miguelmanguerra/Gripper-Arm/Budget/Receipts and Photos/JLCPCB Invoice.pdf

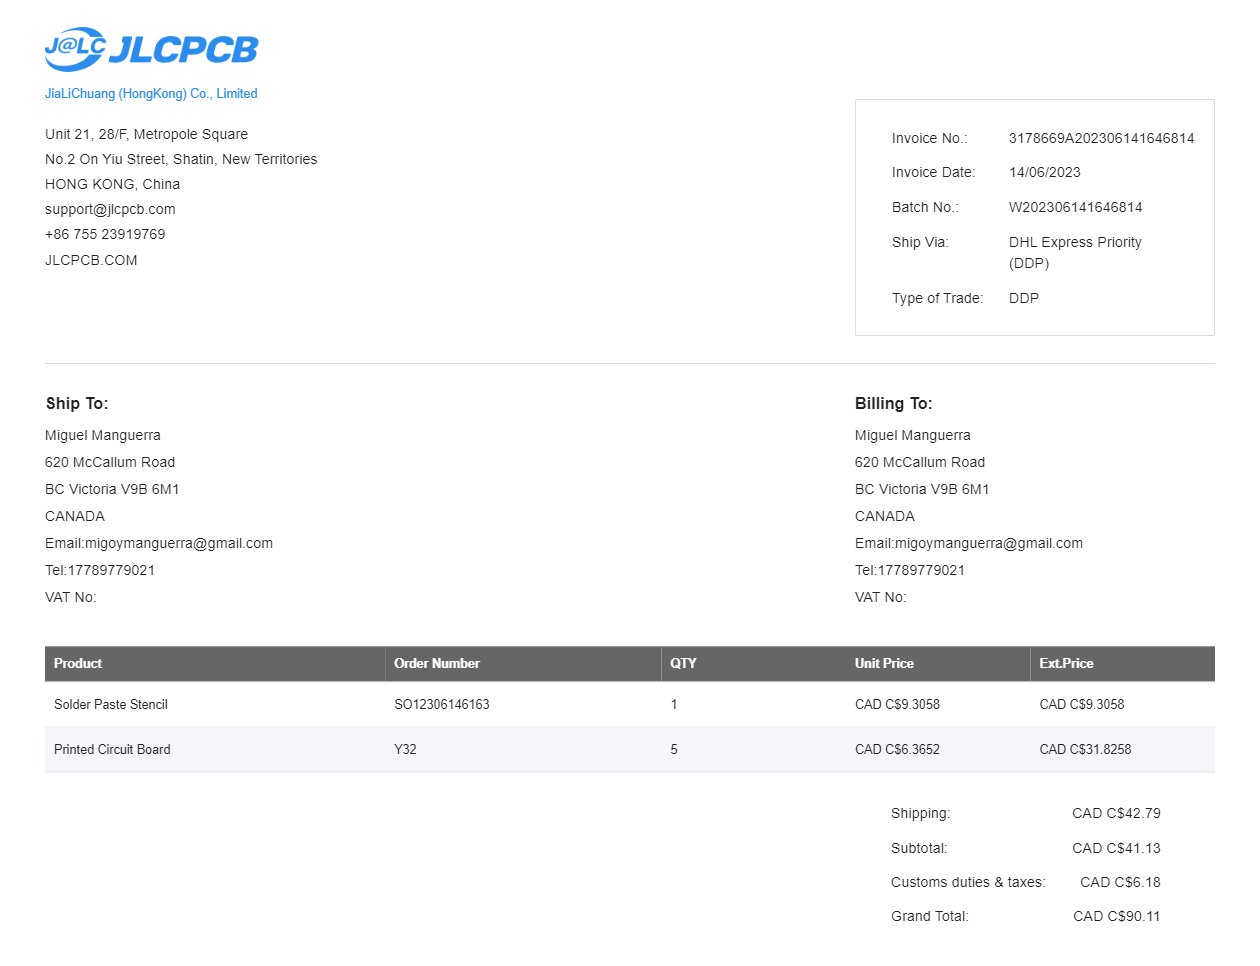
[picture p1: figure]
