miguelmanguerra/Gripper-Arm/Budget/Receipts and Photos/Force Sensors - DigiKey.png

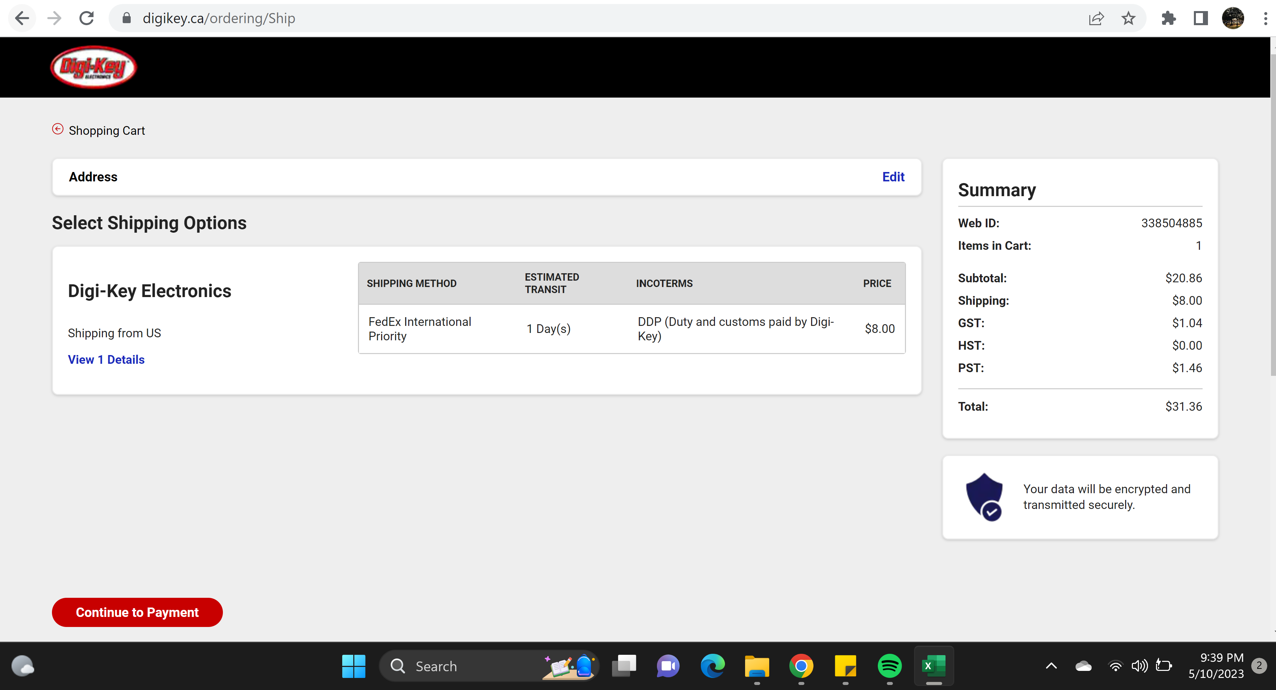
Budget/Receipts and Photos/Force Sensors - DigiKey.png
