miguelmanguerra/Gripper-Arm/Budget/Receipts and Photos/Force Sensors Reciept - DigiKey.png

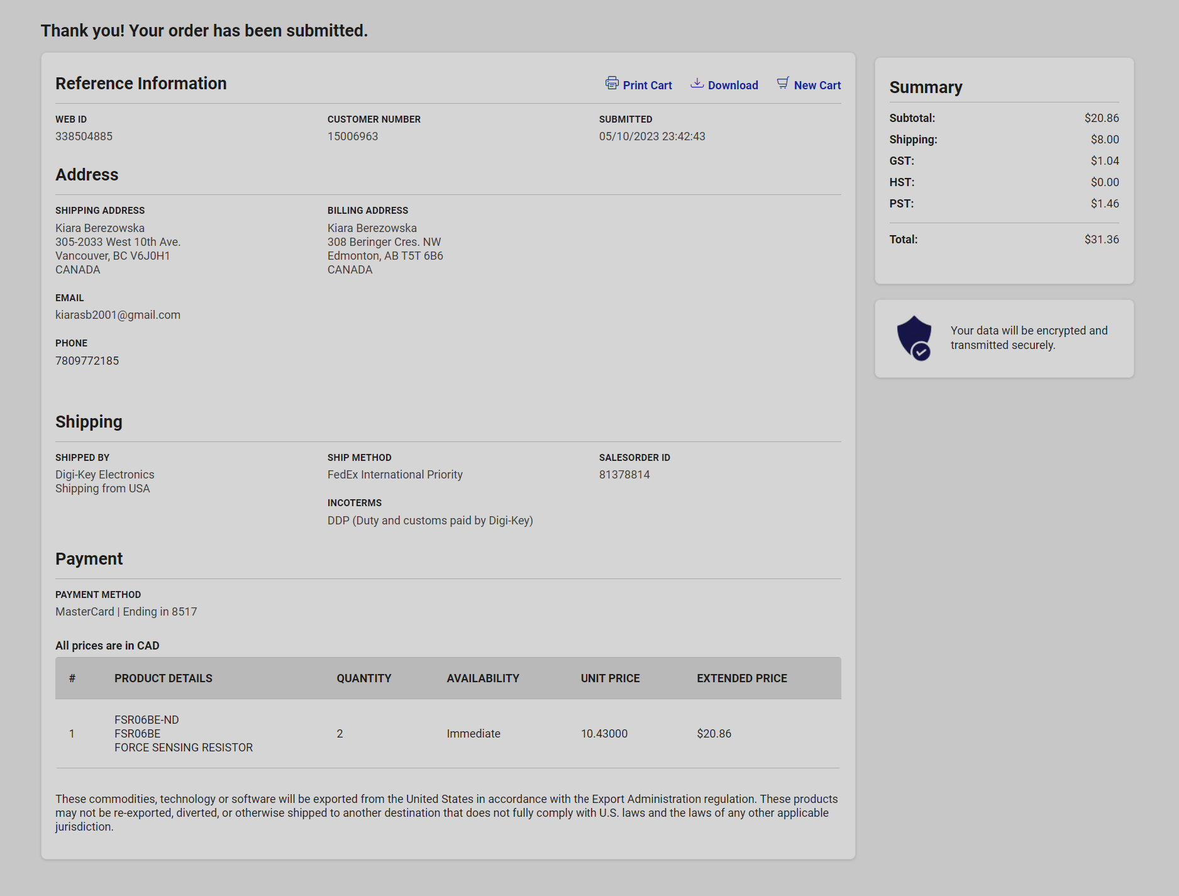
Budget/Receipts and Photos/Force Sensors Reciept - DigiKey.png
