miguelmanguerra/Gripper-Arm/Budget/Receipts and Photos/JLCPCB Credit Card Charge.png

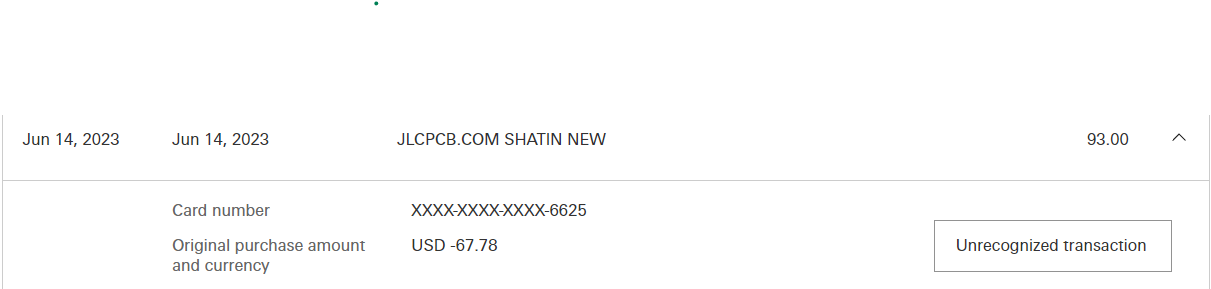
Budget/Receipts and Photos/JLCPCB Credit Card Charge.png
