miguelmanguerra/Gripper-Arm/Electrical/Gripper PCB/Manufacturing Files/BOM/BOM/Bill of Materials-Gripper PCB(X1).xlsx

Sheet: Manufacturing
 |  | Bill of Materials for |  | Gripper PCB.PrjPcb
 |  | Source Data From: | Gripper PCB.PrjPcb
 |  | Variant: | X1
 |  | Report Date: | 2023-06-14 1:41 AM
 |  |  |  | Primary |  |  |  |  | Secondary
Altium Vault P/N | Designator | Description | Qty | Supplier | Supplier Part Number | Manufacturer | Manufacturer Part Number | Supplier Unit Price | Supplier | Supplier Part Number | Manufacturer | Manufacturer Part Number | Supplier Unit Price
CM105X7R105K16ATH, GRT188C8YA105KE13D, CC0603KRX7R6BB105 | C1, C2, C9, C28, C29 | CAP CER 1UF 16V X7R 0603, CAP CER 1UF 35V X6S 0603, CAP CER 1UF 10V X7R 0603 | 5 | DigiKey | 478-CM105X7R105K16ATHCT-ND, 490-12297-1-ND, 311-1796-1-ND
C0603X104M3RAC7867, C0603C104K5RAC7411 | C3, C5, C6, C7, C10, C11, C12, C13, C16, C24, C30, C31, C32, C36, C37, C38 | CAP CER 0.1UF 25V X7R 0603, CAP CER 0.1UF 50V X7R 0603 | 16 | DigiKey | 399-13148-1-ND, 399-C0603C104K5RAC7411CT-ND
GRT188C81E475KE13D | C4 | CAP CER 4.7UF 25V X6S 0603 | 1 | DigiKey | 490-12295-1-ND
GRT188R61C106ME13D | C8 | CAP CER 10UF 16V X5R 0603 | 1 | DigiKey | 490-12318-1-ND
VJ0603A180JXACW1BC | C14, C15 | CAP CER 18PF 50V C0G/NP0 0603 | 2 | DigiKey | 720-1524-1-ND
CL32B106KBJNNNE | C17, C18, C19, C20, C25 | CAP CER 10UF 50V X7R 1210 | 5 | DigiKey | 1276-3387-1-ND
CL21A475KBQNNNE | C21, C22 | CAP CER 4.7UF 50V X5R 0805 | 2 | DigiKey | 1276-1248-1-ND
GRM1885C1H272JA01D | C23 | CAP CER 2700PF 50V C0G/NP0 0603 | 1 | DigiKey | 490-3283-1-ND
CL31A226KAHNNNE | C26, C27 | CAP CER 22UF 25V X5R 1206 | 2 | DigiKey | 1276-3047-1-ND
06035C332JAT2A | C33, C34, C35 | CAP CER 3300PF 50V X7R 0603 | 3 | DigiKey | 478-10808-1-ND
UWR1E220MCL1GB | C39, C40 | CAP ALUM 22UF 20% 25V SMD | 2 | DigiKey | 493-16362-1-ND
LTST-C193TBKT-5A | D1, D3 | LED BLUE CLEAR CHIP SMD | 2 | DigiKey | 160-1827-1-ND
XZVGT53W-6 | D2, D5, D8, D10, D14 | LED GREEN CLEAR 2SMD | 5 | DigiKey | 1497-1243-1-ND
LTST-C190KAKT | D4 | LED RED CLEAR CHIP SMD | 1 | DigiKey | 160-1433-1-ND
ESD3V3D5B-TP | D6 | TVS DIODE 3.3VWM 12VC SOD523 | 1 | DigiKey | ESD3V3D5B-TPMSCT-ND
V3FL45-M3/H | D7 | 3A,45V,SMF,TRENCH SKY RECT. | 1 | DigiKey | V3FL45-M3/HGICT-ND
BAT165E6327HTSA1 | D9 | DIODE SCHOTT 40V 750MA SOD323-2 | 1 | DigiKey | BAT165E6327HTSA1CT-ND
TPD1E10B06QDPYRQ1 | D11 | TVS DIODE 5.5VWM 14VC 2X1SON | 1 | DigiKey | 296-TPD1E10B06QDPYRQ1CT-ND
ESD321DPYR | D12, D13 | TVS DIODE 3.6VWM 6.8VC 2X1SON | 2 | DigiKey | 296-51108-1-ND
CMP-00073-2 | IC1 | Voltage Level Translator Bidirectional 2 Circuit 4 Channel 100Mbps 14-TSSOP | 1 | DigiKey | 1727-NXB0104PWJCT-ND
CMP-00068-2 | IC2 | Buck Switching Regulator IC Positive Adjustable 0.8V 1 Output 3A 8-SOIC (0.154, 3.90mm Width) Exposed Pad | 1 | DigiKey | 1028-1502-1-ND
CMP-00074-1 | IC3 | LDO Regulator Positive Adj 0.8V to 5V 600mA 5-Pin SOT-25 T/R | 1 | DigiKey | AP7366-W5-7DICT-ND
CMP-00069-1 | IC4 | IC BRUSHED DC MOTOR 8SOIC | 1 | DigiKey | 296-43024-1-ND
10118193-0001LF | J1 | CONN RCPT USB2.0 MICRO B SMD R/A | 1 | DigiKey | 609-4616-2-ND
CMP-00070-1 | J2, J4, J5 | Connector Header 2 Position 3 mm Solder Right Angle Thru-Hole 2 Terminal 1 Port Micro-Fit 3.0™ | 3 | DigiKey | WM1860-ND
CMP-00071-1 | J3 | Connector Wire to Board Header 4 Position 3mm Solder Right Angle Thru-Hole Tray | 1 | DigiKey | WM1862-ND
SLF7032T-100M1R4-2PF | L1 | FIXED IND 10UH 1.4A 63.6 MOHM | 1 | DigiKey | 445-1998-1-ND
SRN4018-4R7M | L2 | FIXED IND 4.7UH 1.9A 84 MOHM SMD | 1 | DigiKey | SRN4018-4R7MCT-ND
CMP-00028-00002-1 | MH1, MH2 | M3 Mounting Hole Exposed | 2
CMP-14406-000041-1 | Q1, Q2 | TRANS NPN 45V 500MA TO236AB | 2 | DigiKey | 1727-4844-1-ND
RT0603FRE0710KL, RC0603FR-7W10KL | R1, R4, R5, R6, R10, R15, R25, R31, R32 | RES SMD 10K OHM 1% 1/10W 0603, RES 10K OHM 1% 1/5W 0603 | 9 | DigiKey | YAG2321CT-ND, 13-RC0603FR-7W10KLCT-ND
CRCW06031K00FKEB, RT0603FRE071KL | R2, R3, R7, R8, R9 | RES SMD 1K OHM 1% 1/10W 0603 | 5 | DigiKey | 541-2985-1-ND, YAG2323CT-ND
TLRZ1JTTD | R13, R14, R20, R21, R23 | RES 0 OHM JUMPER 0603 | 5 | DigiKey | 2019-TLRZ1JTTDCT-ND
RT0603FRE0747KL | R16, R19 | RES SMD 47K OHM 1% 1/10W 0603 | 2 | DigiKey | YAG3355CT-ND
RMCF0603FT3K30, ERJ-3EKF3301V | R17, R22 | RES 3.3K OHM 1% 1/10W 0603, RES SMD 3.3K OHM 1% 1/10W 0603 | 2 | DigiKey | RMCF0603FT3K30CT-ND, P3.30KHCT-ND
CRCW060368K0FKEA | R18 | RES SMD 68K OHM 1% 1/10W 0603 | 1 | DigiKey | 541-68.0KHCT-ND
CR0603-FX-3832ELF | R24 | RES SMD 38.3K OHM 1% 1/10W 0603 | 1 | DigiKey | CR0603-FX-3832ELFCT-ND
RL73H2ER10FTDF | R26 | RES 0.1 OHM 1% 1/2W 1210 | 1 | DigiKey | A138544CT-ND
ERJ-3EKF4700V | R27, R29, R30 | RES SMD 470 OHM 1% 1/10W 0603 | 3 | DigiKey | P470HCT-ND
CRCW0603154KFKEA | R28 | RES SMD 154K OHM 1% 1/10W 0603 | 1 | DigiKey | 541-154KHCT-ND
CRCW060322K0FKEAC | R33 | RES 22K OHM 1% 1/10W 0603 | 1 | DigiKey | 541-4036-1-ND
RK73H1JTTD6342F | R34 | RES 63.4K OHM 1% 1/10W 0603 | 1 | DigiKey | 2019-RK73H1JTTD6342FCT-ND
EVP-AWBD4A | S1, S2 | 3.0MM X 2.0MM / 1.6N / 0.13MM ST | 2 | DigiKey | P123438CT-ND
CMP-002-00006-1 | TP5, TP6, TP7, TP8, TP9, TP10, TP11, TP12, TP13, TP14, TP15 | 1.5mm Test Point 0.75mm hole size | 11
CMP-0511-00012-1 | U1 | Single-Chip USB to UART Bridge, 1024 Bytes EEPROM, -40 to 85 degC, 28-pin QFN, Tube | 1 | DigiKey | 336-1160-5-ND
CMP-00072-2 | U2 | Rx Txrx Module Wifi U.fl SMD | 1 | DigiKey | 1965-ESP32-WROOM-32UE-N4CT-ND
CMP-0186-00139-2 | U3 | Stand-Alone CAN Controller With SPI Interface, 18-Pin SOIC, Industrial Temperature, Tape and Reel | 1 | DigiKey | MCP2515T-I/SOCT-ND
CMP-2000-04923-2 | U4 | IC TRANSCEIVER HALF 1/1 8SO | 1 | DigiKey | 296-19416-5-ND
CMP-12757-000001-1 | U5 | IC REG BUCK 5V 2A TSOT26 | 1 | DigiKey | AP63205WU-7DICT-ND
CMP-00020-1 | U6 | AEC-Q100, 2.7 to 60V, 800kHz Variable gain current sense amplifier 8-TSSOP -40 to 125 | 1 | DigiKey | 296-17201-1-ND
CMP-0272-00929-3 | U7 | Single-Supply, Rail-to-Rail Operational Amplifier MicroAmplifier(TM) Series, 2.7 to 5.5 V, -40 to 85 degC, 5-pin SOT23 (DBV5), Green (RoHS & no Sb/Br) | 1 | DigiKey | 296-26275-1-ND
CMP-0272-00789-3 | U8 | Single-Supply, Rail-to-Rail Operational Amplifier MicroAmplifier(TM) Series, 2.5 to 5.5 V, -40 to 85 degC, 8-pin SOIC (D8), Green (RoHS & no Sb/Br) | 1 | DigiKey | 296-26254-1-ND
NX5032GA-8MHZ-EXS00A-CG07039 | Y1 | CRYSTAL 8.0000MHZ 18PF SMD | 1 | DigiKey | 644-1318-1-ND

Sheet: Project Information
Project Full Path | C:\Gripper-Arm\Electrical\Gripper PCB\Gripper PCB.PrjPcb
Project Filename | Gripper PCB.PrjPcb
Variant Name | X1
Data-Source Filename | Gripper PCB.PrjPcb
Data-Source Full Path | C:\Gripper-Arm\Electrical\Gripper PCB\Gripper PCB.PrjPcb
Title | Bill of Materials for Variant [X1] of Project [Gripper PCB.PrjPcb] (No PCB Document Selected)
Total Quantity | 123
Report Time | 1:41 AM
Report Date | 2023-06-14
Report Date & Tine | 2023-06-14 1:41 AM
Output Name | Bill of Materials
Output Type | BomReport
Output Generator Name | BOM
Output Generator Description | Bill of Materials
