miguelmanguerra/Gripper-Arm/Budget/Receipts.xlsx

Person | Date | Description | Supplier | Cost Per Item | Quantity | Total Cost with Taxes and Shipping | Is Reciept Photo in Folder? | Which Credit Card?
Kiara | 2023-05-10 | Force sensors | DigiKey | $10.43 | 2 | $31.36 | Yes | Servus
Miguel | 2023-06-14 | PCB | JLCPCB | $41.13 | 1 | $90.73 | Yes | HSBC
Miguel | 2023-06-15 | PCB Components | Digikey | $225.99 | 1 | $253.11 | Yes | HSBC
