miguelmanguerra/Gripper-Arm/Mechanical/ASSY, GRIPPER, ROBOTIC ARM, 2023.SLDASM

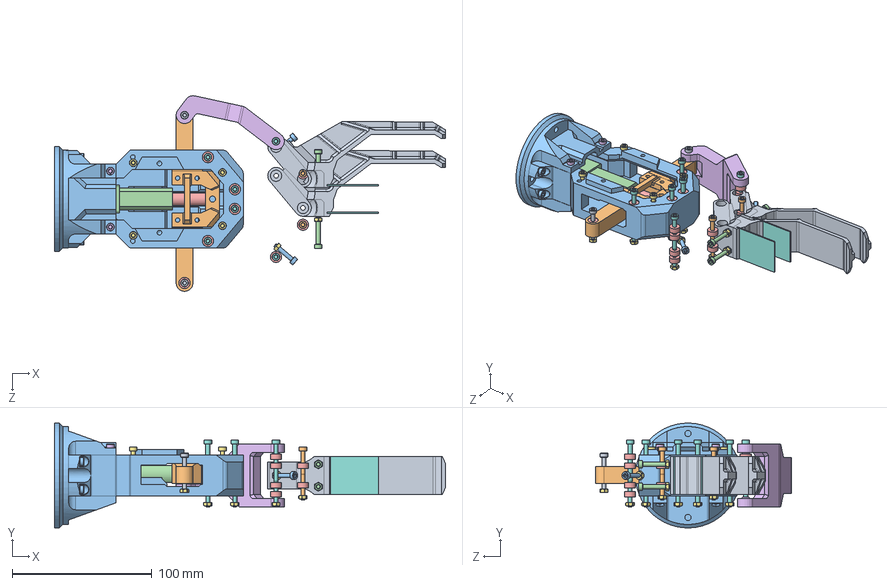
[picture p5: CAD file, 2023-05-04]
Mechanical/ASSY, GRIPPER, ROBOTIC ARM, 2023.SLDASM
279.6 x 75.0 x 139.9 mm
GRIPPER BODY,V2
LINEAR ACTUATOR, BODY,V2
LINEAR ACTUATOR, PISTON,V2
R1, GRIPPER,V2
90592A009_Steel Hex Nut x 20
91290A079_Alloy Steel Socket Head Screw x 6
91290A125_Black-Oxide Alloy Steel Socket Head Screw M3 x 25 x 2
91290A135_Alloy Steel Socket Head Screw x 2
91290A120_Alloy Steel Socket Head Screw x 6
91290A123_Alloy Steel Socket Head Screw x 4
693ZZ BEARING x 21
91290A136_Alloy Steel Socket Head Screw x 2
SLIDER V2, CFN, GRIPPER
FINGER, GRIPPER V2 x 2
91290A111_Alloy Steel Socket Head Screw (1) x 4
RUBBER PAD, GRIPPER, 2023 x 2
