miguelmanguerra/Gripper-Arm/Mechanical/GRIPPER BODY,V2.SLDPRT

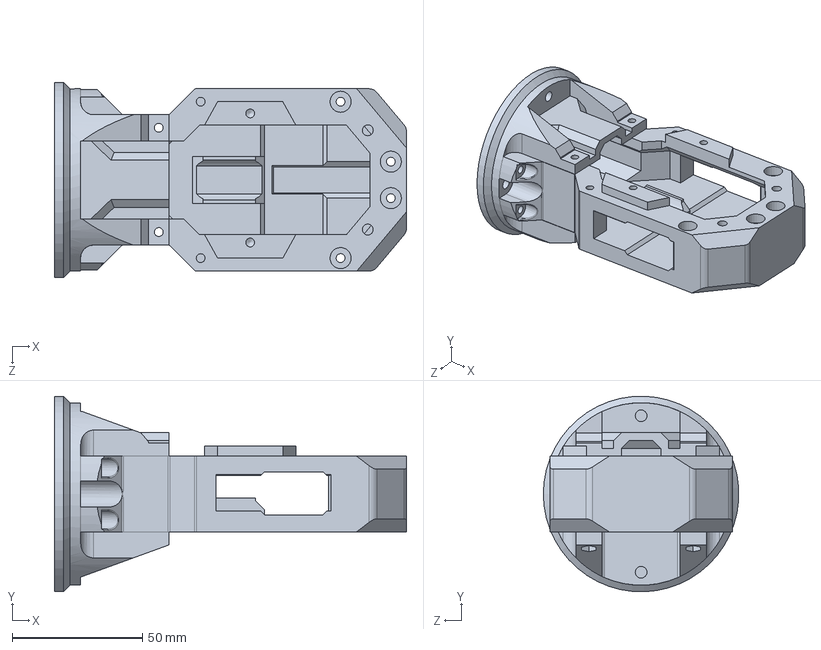
[picture p6: CAD file, 2023-06-16]
Mechanical/GRIPPER BODY,V2.SLDPRT
135.0 x 75.0 x 74.9 mm
