miguelmanguerra/Gripper-Arm/Mechanical/FINGER, GRIPPER V2.SLDPRT

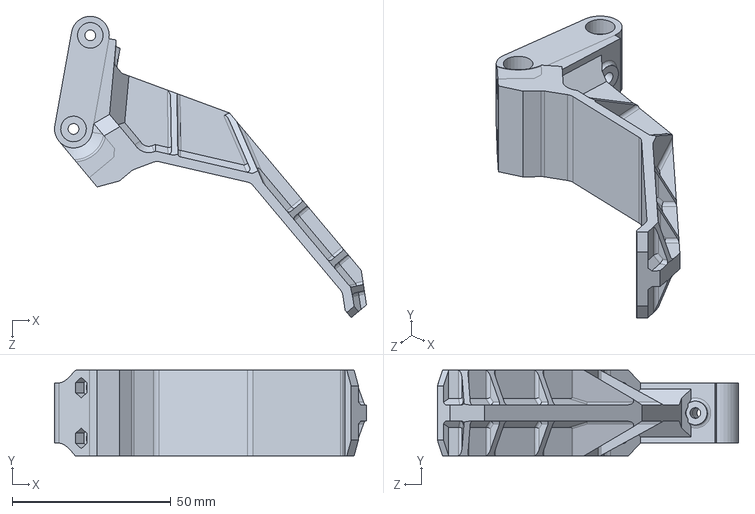
[picture p7: CAD file, 2023-05-04]
Mechanical/FINGER, GRIPPER V2.SLDPRT
98.4 x 27.0 x 95.1 mm
