miguelmanguerra/Gripper-Arm/Mechanical/FINGER, GRIPPER.SLDPRT

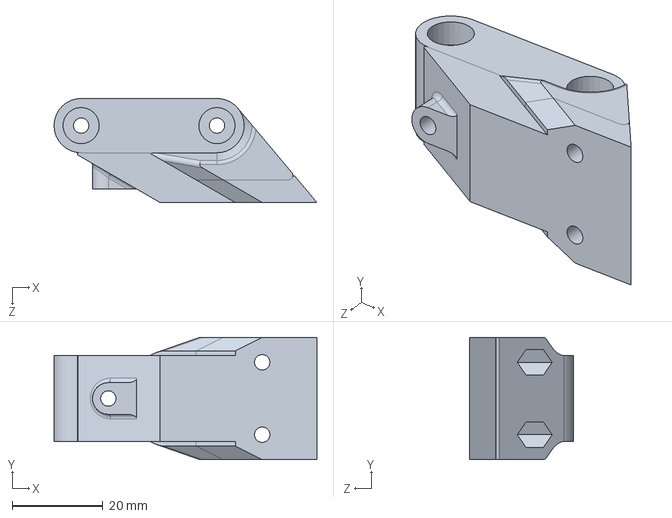
[picture p8: CAD file, 2023-05-04]
Mechanical/FINGER, GRIPPER.SLDPRT
58.1 x 27.0 x 23.0 mm
