miguelmanguerra/Gripper-Arm/Mechanical/SLIDER V2, CFN, GRIPPER.SLDPRT

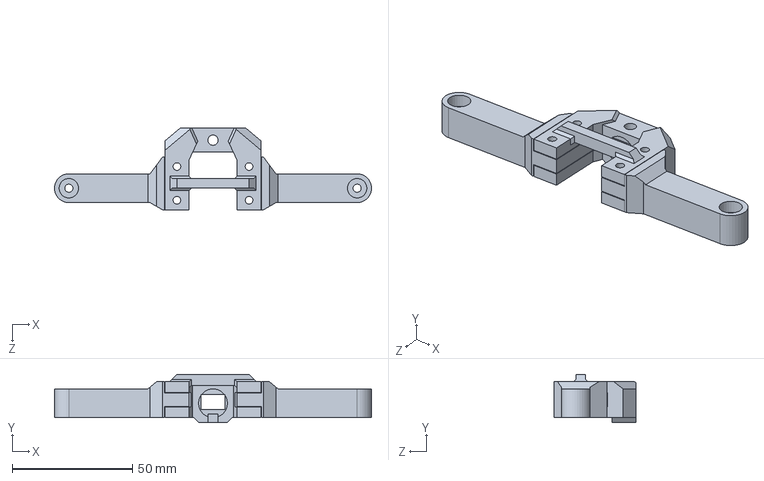
[picture p9: CAD file, 2023-05-04]
Mechanical/SLIDER V2, CFN, GRIPPER.SLDPRT
131.9 x 20.0 x 34.0 mm
