miguelmanguerra/Gripper-Arm/(list of files, cad)

Other CAD files:
Mechanical/3D Printed Solder Holder.STL
Mechanical/90592A009_Steel Hex Nut.SLDPRT
Mechanical/91290A079_Alloy Steel Socket Head Screw.SLDPRT
Mechanical/91290A111_Alloy Steel Socket Head Screw (1).SLDPRT
Mechanical/91290A120_Alloy Steel Socket Head Screw.SLDPRT
Mechanical/91290A123_Alloy Steel Socket Head Screw.SLDPRT
Mechanical/91290A125_Black-Oxide Alloy Steel Socket Head Screw M3 x 25.SLDPRT
Mechanical/91290A135_Alloy Steel Socket Head Screw.SLDPRT
Mechanical/91290A136_Alloy Steel Socket Head Screw.SLDPRT
Mechanical/ASSY, GRIPPER, ROBOTIC ARM, 2023.DXF
