miguelmanguerra/Gripper-Arm/Software/Force Sensor Testing.xlsx

Sheet: Sheet1
FSR_2 Input test
Load (kg) | Voltage tst 1 (V)
0 | 3.46
0.1 | 1.7
0.2 | 0.56
0.3 | 0.46
0.4 | 0.35
0.5 | 0.29
0.6 | 0.28
0.7 | 0.247
0.8 | 0.21
0.9 | 0.2
1 | 0.195
1.5 | 0.14
2 | 0.11
2.5 | 0.103
3 | 0.101
3.5 | 0.099
4 | 0.079
4.5 | 0.076

Sheet: Sheet2
Current Sensor Testing
Current (A) | ADC Reading
0.095 | 51.8
0.111 | 82.5
0.127 | 123
0.133 | 149.2
0.142 | 179.7
0.158 | 242.7
0.165 | 280.2
0.17 | 303.6
0.181 | 343.7
0.19 | 387.3
0.198 | 463.1
0.204 | 512.9
0.211 | 561.5
0.22 | 614.7

Sheet: FSR_2 Input Test + Sensor 2
FSR_2 Input Test + Sensor 2
Load (kg) | Voltage_test 1 (V) | ADC_test 1 | Voltage_test 2 (V) | ADC_test 2 | Voltage_test 3 (V) | ADC_test 3 | Voltage_test 4 (V) | ADC_test 4
0.1 | 0.14 | 48 | 0.12 | 45 | 0.13 | 30 | 0.129 | 25
0.2 | 0.19 | 80 | 0.15 | 46 | 0.19 | 109 | 0.145 | 45
0.3 | 0.27 | 175 | 0.24 | 145 | 0.19 | 100 | 0.21 | 140
0.4 | 0.33 | 260 | 0.28 | 210 | 0.21 | 120 | 0.23 | 150
0.5 | 0.39 | 330 | 0.26 | 290 | 0.25 | 150 | 0.26 | 190
1 | 0.58 | 560 | 0.5 | 450 | 0.32 | 320 | 0.4 | 360
1.5 | 0.56 | 549 | 0.55 | 540 | 0.55 | 530 | 0.5 | 460
2 | 0.6 | 590 | 0.64 | 650 | 0.61 | 590 | 0.56 | 560
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
