miguelmanguerra/Gripper-Arm/Electrical/Force Sensor Validation.xlsx

Equipment Used | Sensor 1 |  | Sensor 2 |  | Voltage Divider Calculations |  | Input Voltage | 3.3
Force Sensor - SHIMPO 30kg | Applied Force [kg] | Resistance [Ohms] | Applied Force [kg] | Resistance [Ohms] | Resistance (Force Sensor) | R2 Resistance | Output | Resolution
Multimeter - FLUKE 117 | 0.2 | 150000 | 0.2 | N/A | 150000 | 10000 | 0.20625
 | 0.4 | 30000 | 0.4 | 24000 | 145000 | 10000 | 0.2129032258 | 0.006653225806
 | 0.6 | 8000 | 0.6 | 10000 | 140000 | 10000 | 0.22 | 0.007096774194
 | 0.8 | 7900 | 0.8 | 6000 | 135000 | 10000 | 0.2275862069 | 0.007586206897
 | 1 | 6000 | 1 | 5900 | 130000 | 10000 | 0.2357142857 | 0.008128078818
 | 2 | 2000 | 2 | 1500 | 125000 | 10000 | 0.2444444444 | 0.00873015873
 | 3 | 500 | 3 | 1000 | 120000 | 10000 | 0.2538461538 | 0.009401709402
 | 4 | 450 | 4 | 600 | 115000 | 10000 | 0.264 | 0.01015384615
 | 5 | 230 | 5 | N/A | 110000 | 10000 | 0.275 | 0.011
 |  |  |  |  | 105000 | 10000 | 0.2869565217 | 0.01195652174
 |  |  |  |  | 100000 | 10000 | 0.3 | 0.01304347826
 |  |  |  |  | 95000 | 10000 | 0.3142857143 | 0.01428571429
 |  |  |  |  | 90000 | 10000 | 0.33 | 0.01571428571
 |  |  |  |  | 85000 | 10000 | 0.3473684211 | 0.01736842105
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
