miguelmanguerra/Gripper-Arm/Electrical/Gripper PCB/Manufacturing Files/Gripper PCB.pdf

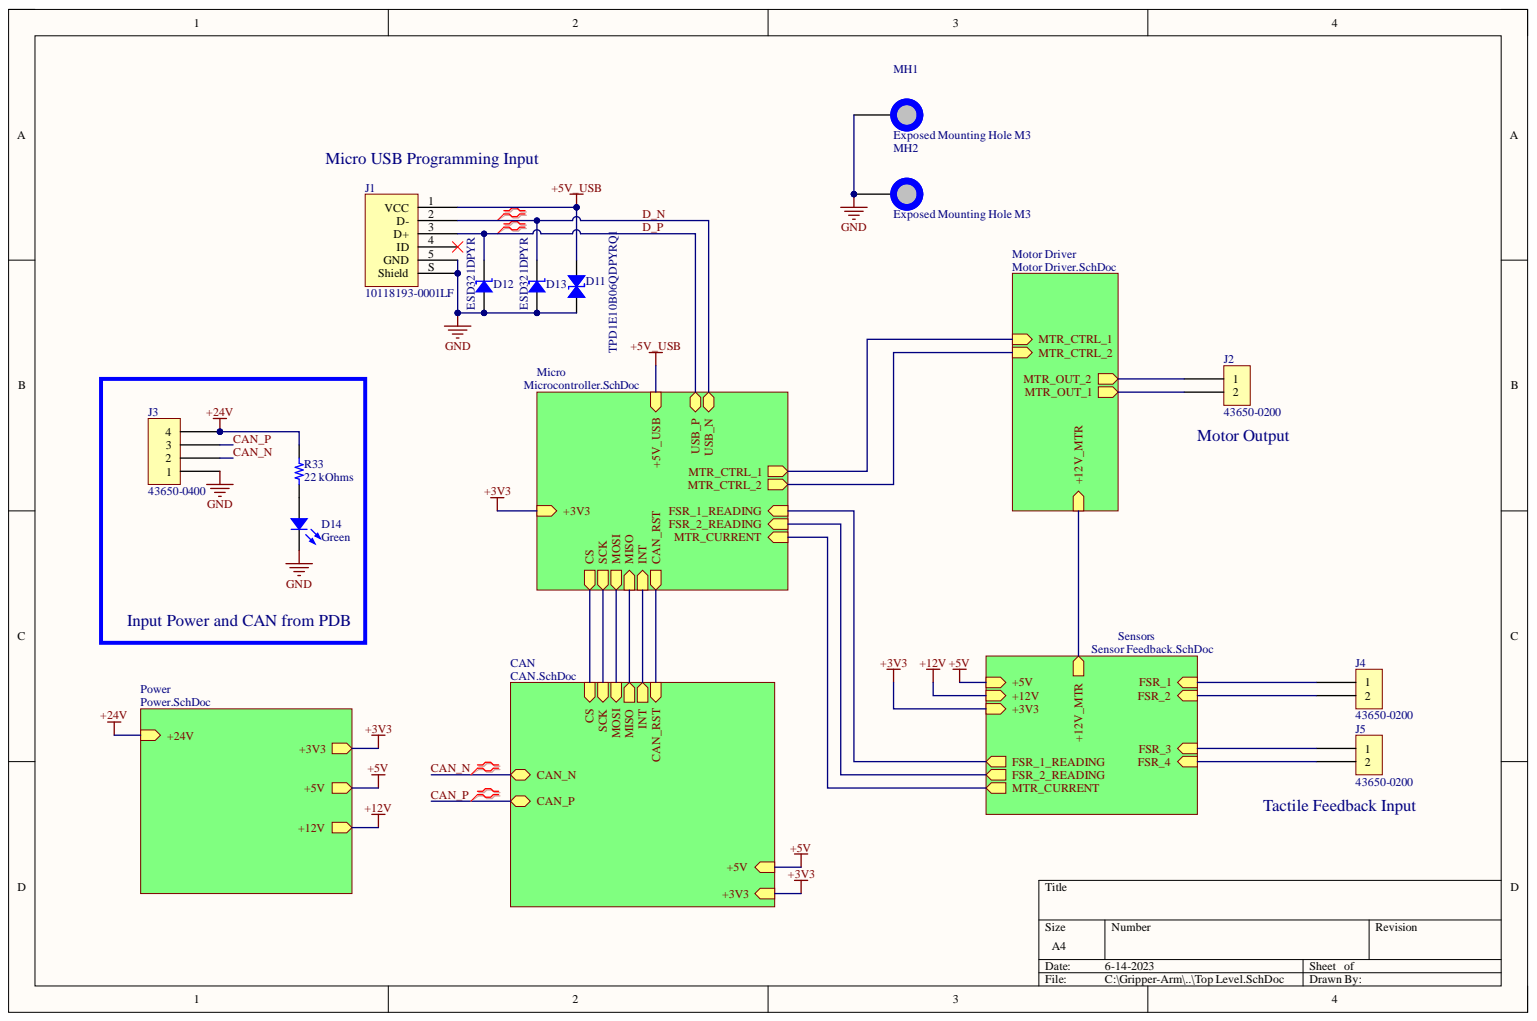
[picture p10: page 1]

Micro USB Programming Input

Input Power and CAN from PDB

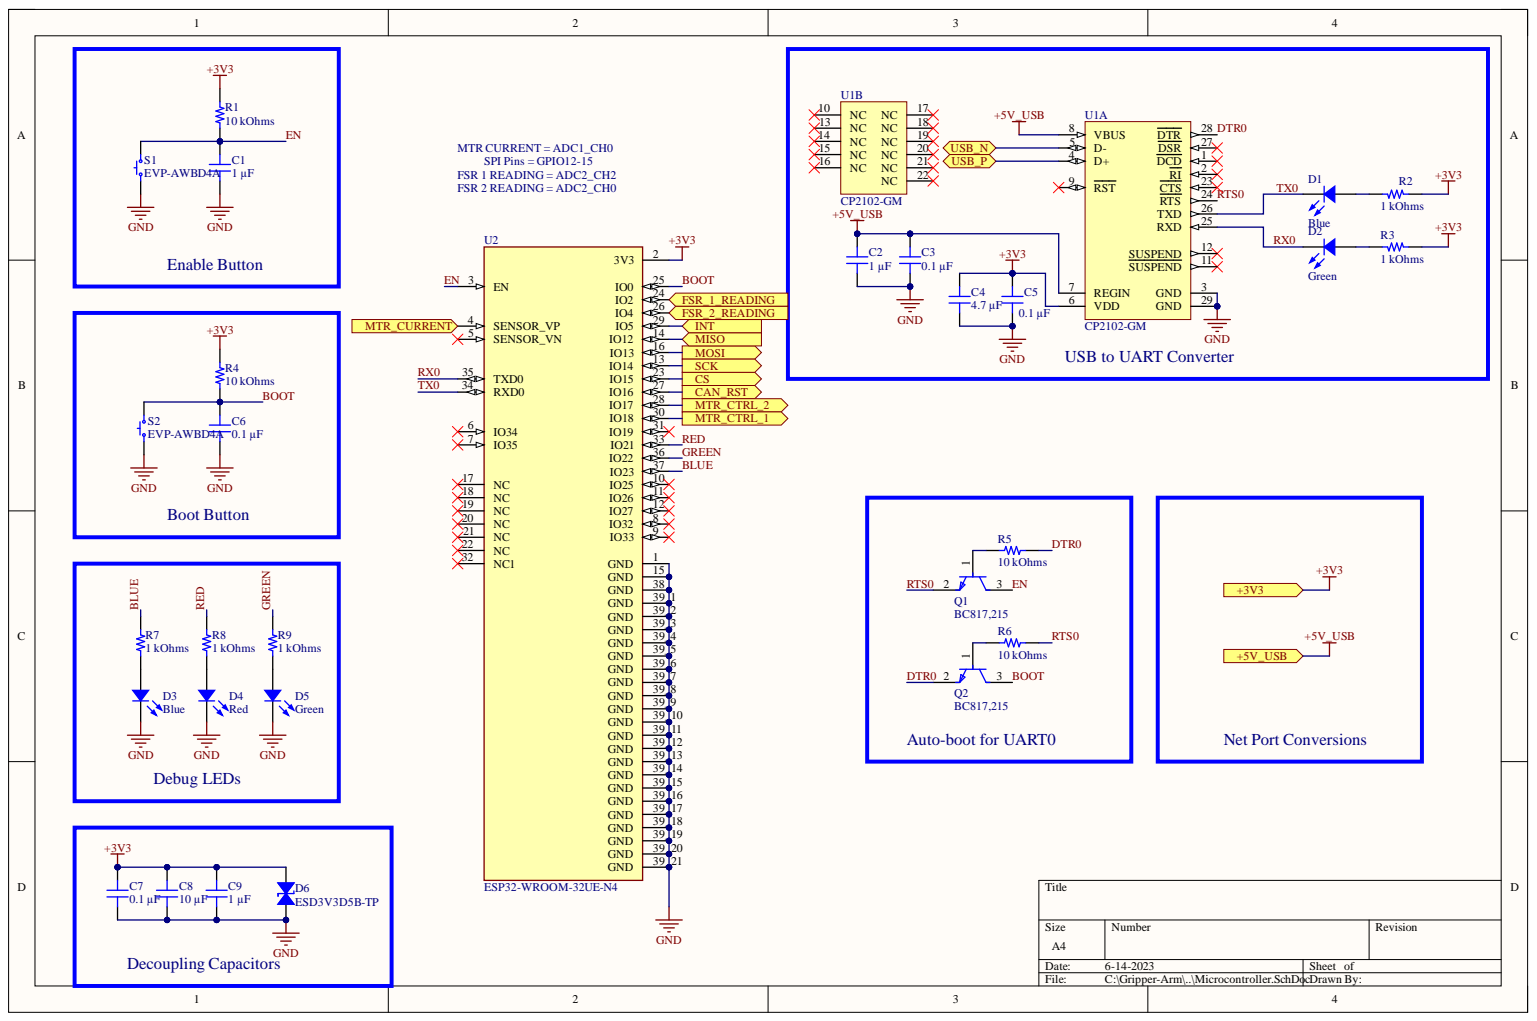
[picture p11: page 2]

VDD 6 REGIN 7

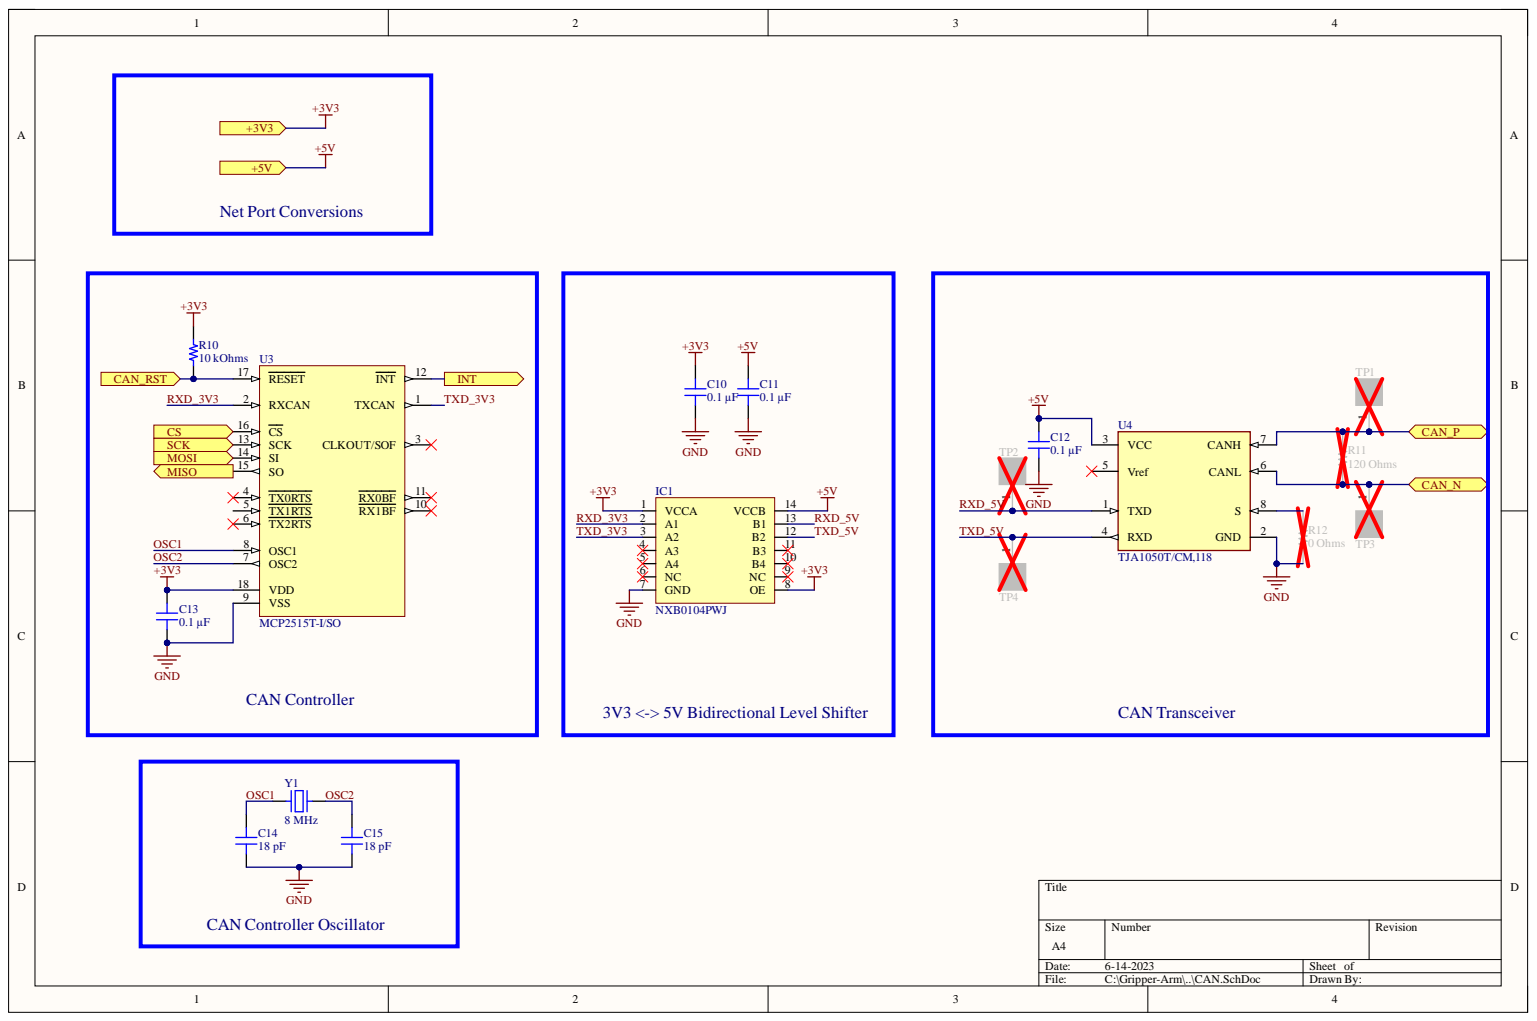
[picture p12: page 3]

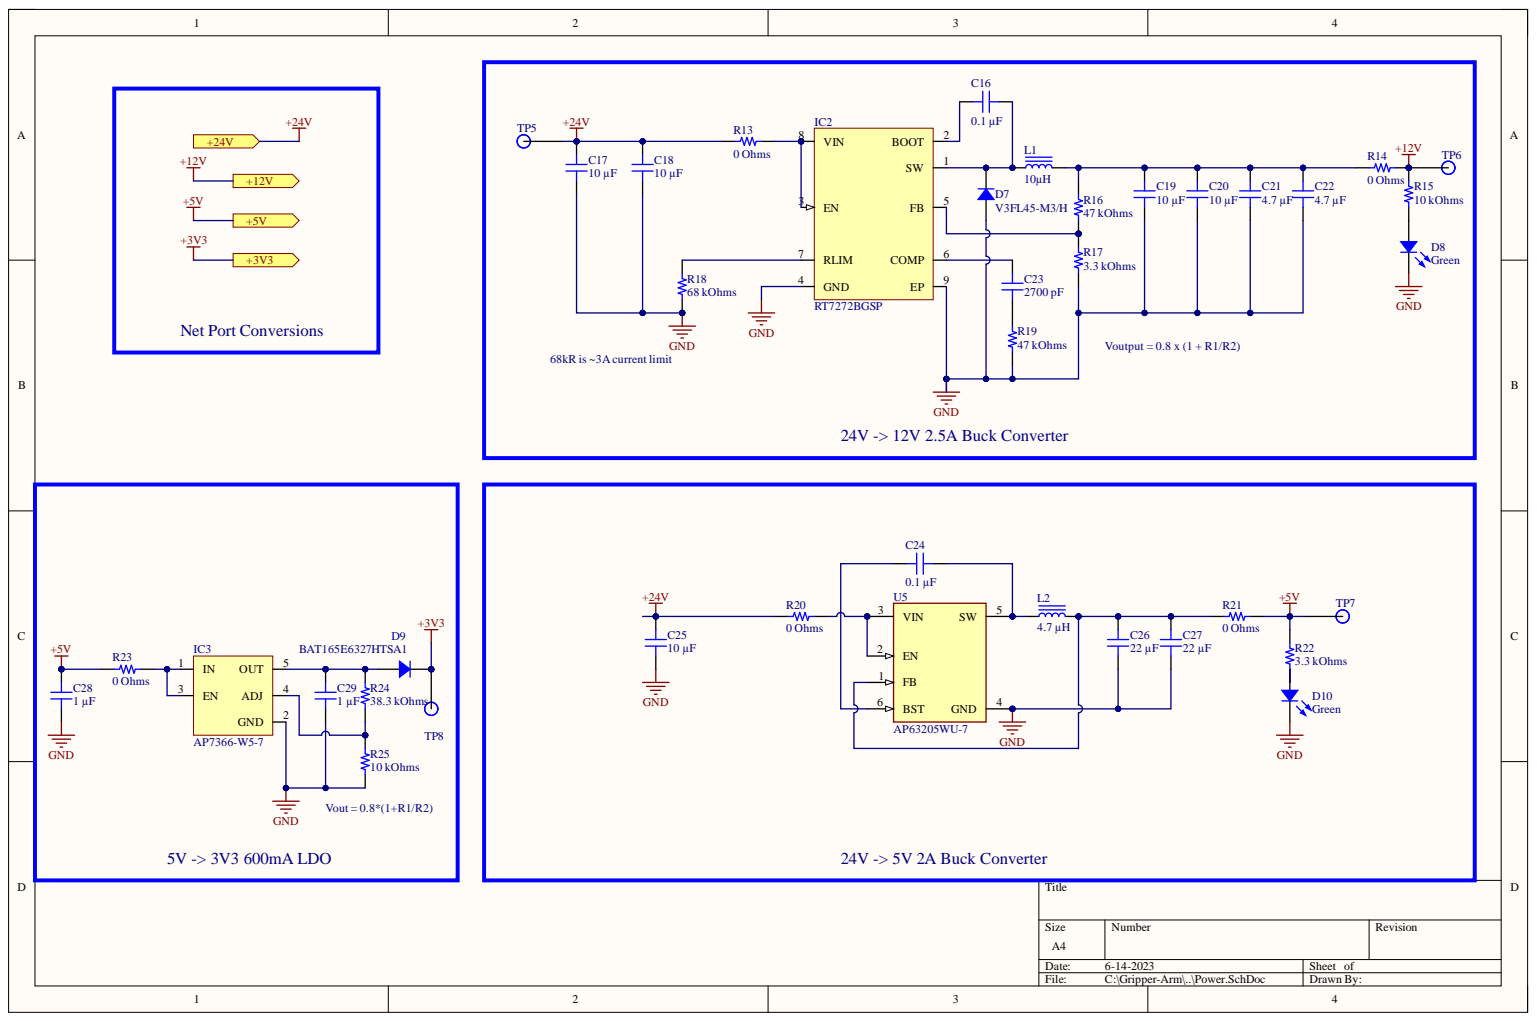
[picture p13: page 4]

BST 6

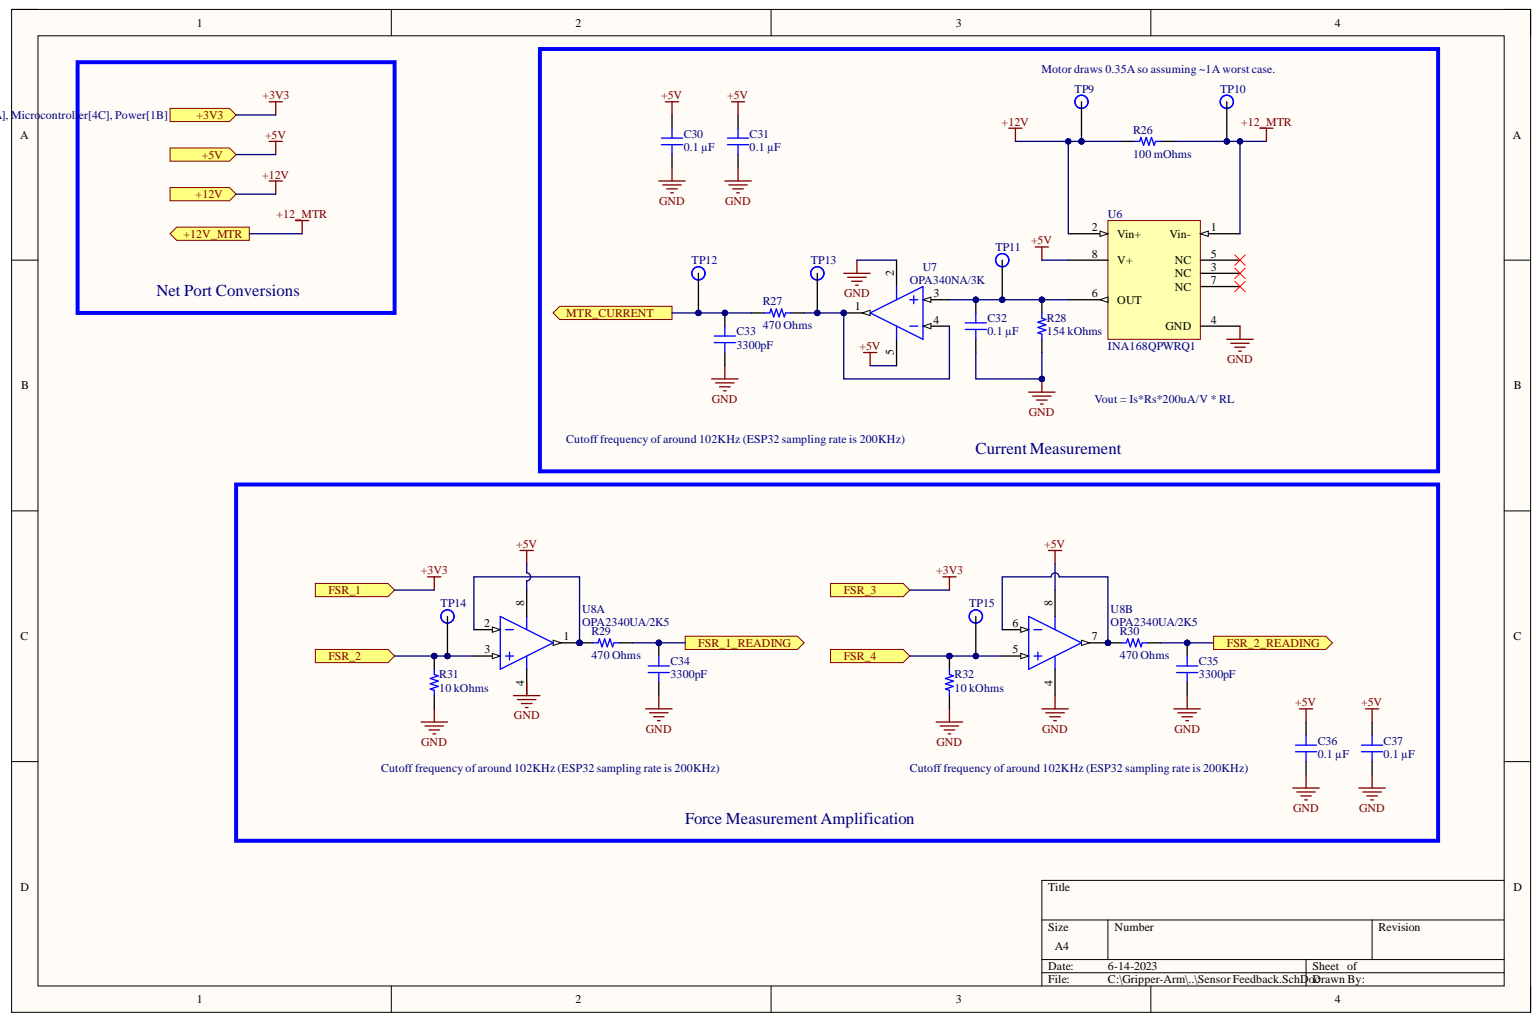
[picture p14: page 5]

Motor draws 0.35A so assuming ~1A worst case.

Vout = Is*Rs*200uA/V * RL

Cutoff frequency of around 102KHz (ESP32 sampling rate is 200KHz)

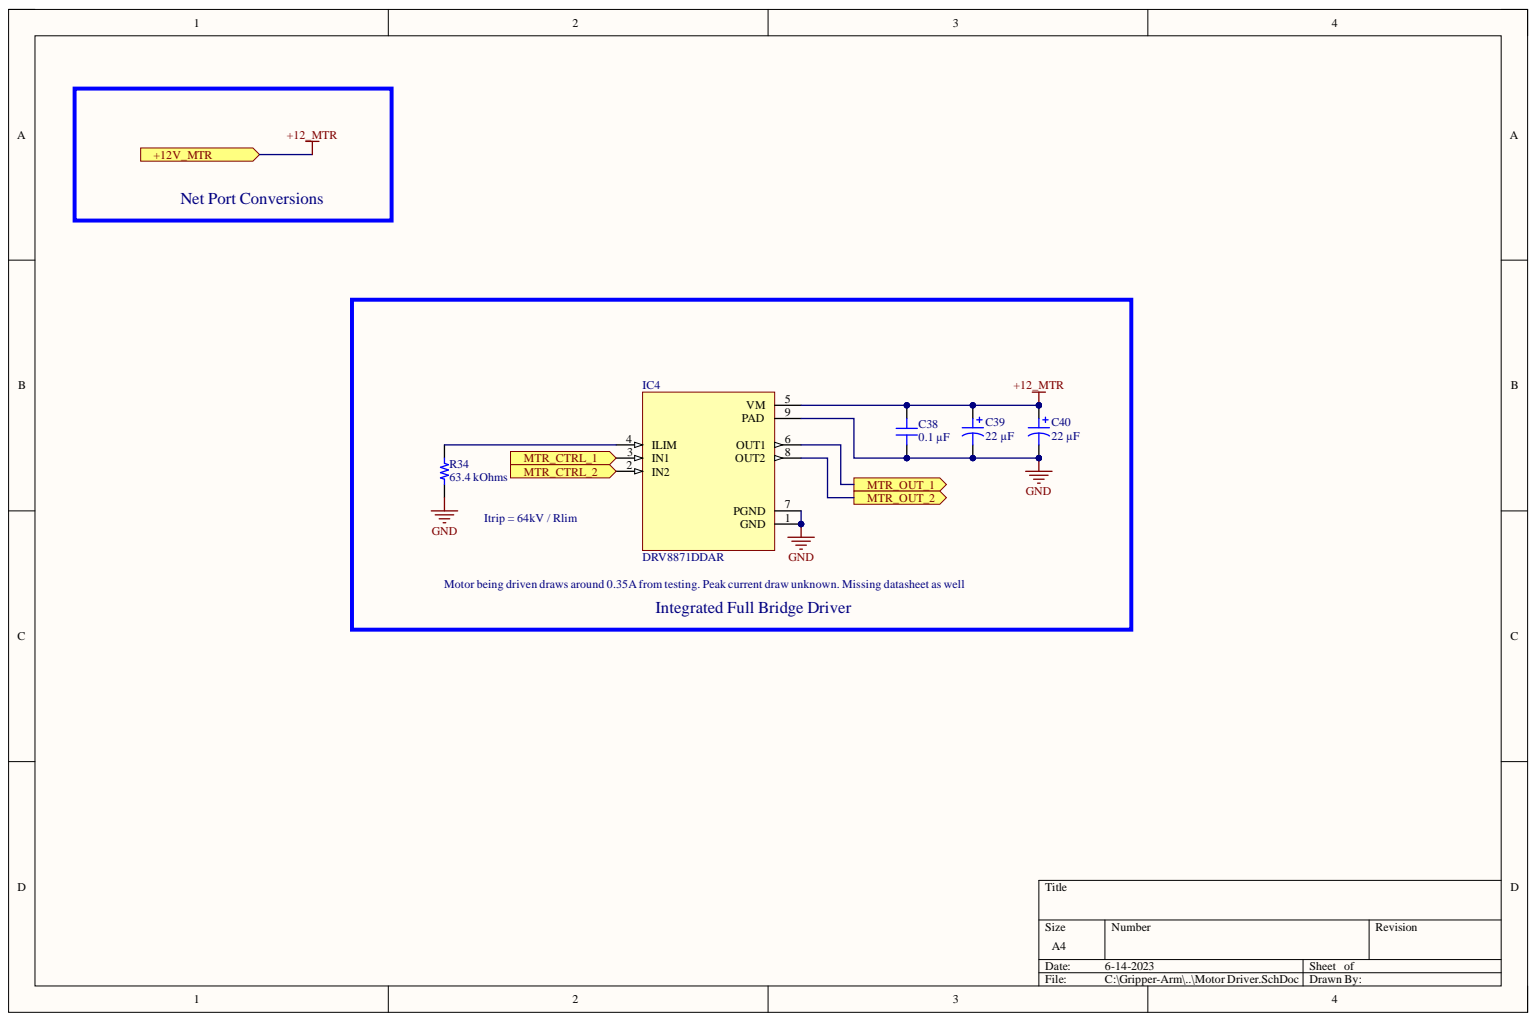
[picture p15: page 6]

Motor being driven draws around 0.35A from testing. Peak current draw unknown. Missing datasheet as well

Integrated Full Bridge Driver
