miguelmanguerra/Gripper-Arm/(list of files, drawings)

Other design files:
Electrical/Gripper PCB/CAN.SchDoc
Electrical/Gripper PCB/Gripper PCB.PcbDoc
Electrical/Gripper PCB/Gripper PCB.PrjPcb
Electrical/Gripper PCB/Microcontroller.SchDoc
Electrical/Gripper PCB/Motor Driver.SchDoc
Electrical/Gripper PCB/Power.SchDoc
Electrical/Gripper PCB/Sensor Feedback.SchDoc
Electrical/Gripper PCB/Top Level.SchDoc
