miguelmanguerra/Gripper-Arm/Software/LUT_Test/LUT_Test.ino

// (C) 2019 Helmut Weber

// use with Serial Plotter

// DO NOT FORGET TO WIRE PIN 25 WITH PIN 35 !!!

// Slope Factor: 
// dac_output_voltage(DAC_CHANNEL_1, 200);     200=8 bit, gives My200VoltV measured with external instrument
// 
float My200Volt = 2.44;  // measured with external instrument: adc(200)

#include <driver/dac.h>


 int ADC_LUT[4096] = { 0,
0,66,70,74,78,81,82,83,85,86,87,89,90,91,92,94,
95,96,97,98,99,100,101,102,103,104,105,106,106,107,108,109,
110,111,112,113,114,115,116,117,118,119,120,121,122,123,124,125,
126,127,128,130,131,132,133,134,135,136,137,138,139,140,142,143,
144,145,146,148,149,151,152,153,155,156,158,159,160,161,162,163,
164,165,166,167,168,169,170,171,172,173,174,175,176,177,178,179,
180,181,182,183,184,185,186,188,189,190,191,192,193,194,195,196,
198,199,200,201,202,203,204,205,207,208,209,210,211,212,213,214,
215,217,218,219,220,221,222,223,224,226,227,228,230,231,232,234,
235,236,237,239,240,241,242,243,244,245,246,247,248,249,250,251,
252,253,254,255,256,257,258,259,260,261,263,264,265,266,267,268,
270,271,272,273,274,275,277,278,279,280,281,282,283,284,286,287,
288,289,290,291,292,293,294,295,296,297,298,299,300,301,302,302,
303,305,306,307,308,309,310,311,313,314,315,316,317,318,319,321,
322,323,324,324,325,326,327,328,329,330,331,332,333,334,335,336,
337,338,339,340,341,342,343,343,344,345,346,347,348,349,350,351,
351,352,354,355,357,358,359,361,362,363,365,366,367,369,370,372,
373,374,376,377,379,380,382,383,384,385,386,387,388,389,390,391,
392,393,394,395,396,397,398,398,399,400,402,403,404,405,407,408,
409,410,412,413,414,416,417,418,419,420,421,422,423,424,425,426,
427,428,428,429,430,431,433,434,435,436,437,439,440,441,442,443,
445,446,447,448,449,450,451,452,453,454,455,456,457,458,459,460,
461,462,463,464,465,466,467,468,470,471,472,473,474,476,477,478,
479,480,481,482,483,484,485,486,487,488,489,490,491,492,493,494,
495,497,499,501,503,506,508,510,512,514,515,516,517,518,520,521,
522,523,525,526,527,528,530,531,532,533,534,535,536,537,539,540,
541,542,543,544,545,546,547,548,550,551,552,553,554,555,556,557,
558,559,560,561,562,563,564,565,567,568,569,570,571,572,573,574,
575,576,577,578,579,581,582,583,584,585,586,587,588,589,590,591,
592,594,595,596,598,599,600,602,603,604,606,607,608,609,610,611,
612,613,614,615,616,617,618,619,620,621,622,623,624,625,626,627,
628,629,630,631,632,633,634,635,636,637,638,639,640,641,642,643,
644,644,645,646,647,648,649,650,650,651,652,653,654,655,656,657,
657,658,659,660,661,662,663,664,665,666,667,668,669,670,671,671,
672,674,675,676,677,678,679,680,682,683,684,685,686,687,688,690,
691,692,693,694,696,697,698,699,701,702,703,704,705,706,708,709,
710,711,712,713,714,715,716,717,718,719,721,722,724,725,727,728,
730,731,733,734,736,737,738,738,739,740,741,742,743,744,744,745,
746,747,748,749,750,751,751,752,753,755,756,757,758,760,761,762,
763,764,766,767,768,769,770,771,772,773,774,776,777,778,779,780,
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
} ;






int a1;

void setup() {
    Serial.begin(115200);
    
    dac_output_enable(DAC_CHANNEL_1);  // pin 25
    dac_output_voltage(DAC_CHANNEL_1, 0);
    

// After calibrating YOUR ESP32:
//     
// Measure   
//     dac_output_voltage(DAC_CHANNEL_1, 200);
// with an external voltmeter (pin 25-ground)
//
// Set your measurement as
//     float My200Volt = (2.44 = your measurement, should be near by);
// at the beginning of the program
//
// Enable the following outcommented lines
// Test YOUR work - with Serial monitor
// Mine is:
// Should be: 2.44V   measured:   2.44
// Should be: 1.22V   measured:   1.21
// Should be: 0.61V   measured:   0.61


//    Enable to test last results:       <<<<<<<<<<<<<<<
//
//    // output  My200Volt
//    
//    dac_output_voltage(DAC_CHANNEL_1, 200);
//    delay(1);
//    
//    Serial.println("Start");
//    delay(1);
//    adcStart(35);
//    delay(1);
//    int a1 = adcEnd(35);
//    a1 = (int)ADC_LUT[a1];  // Correct the value
//    Serial.print("Should be: My200Volt(2.44)   measured:   ");
//    Serial.println((float)(a1>>4)*My200Volt/200.0,2);
//
//    // output 1.22 V
//    
//    dac_output_voltage(DAC_CHANNEL_1, 100);
//    delay(1);
//    adcStart(35);
//    delay(1);
//    a1 = adcEnd(35);
//    a1 = (int)ADC_LUT[a1];  // Correct the value
//    Serial.print("Should be: My200Volt/2   measured:   ");
//    Serial.println((float)(a1>>4)*My200Volt/200.0,2);
//
//    // output 0.61 V
//    
//    dac_output_voltage(DAC_CHANNEL_1, 50);
//    delay(1);
//    adcStart(35);
//    delay(1);
//    a1 = adcEnd(35);
//    a1 = (int)ADC_LUT[a1];  // Correct the value
//    Serial.print("Should be: My200Volt/4   measured:   ");
//    Serial.println((float)(a1>>4)*My200Volt/200.0,2);
//    
//    Serial.println("\npress Reset Button to repeat\n");
//    
//    while(1);
  
}
    

 
void loop() {
  for (int i=0;i<256;i++) {  
      dac_output_voltage(DAC_CHANNEL_1, (i) & 0xff);
      delayMicroseconds(200);
      a1 = analogRead(35);
      a1 = (int)ADC_LUT[a1];  // Correct the value
      Serial.print(i*16); Serial.print(" "); Serial.println(a1);
  }

}
