miguelmanguerra/Gripper-Arm/(commit log)

2023-05-04 Adding Gripper CAD files
    [4mm PIN.SLDPRT, 693ZZ BEARING.SLDPRT, 90592A009_Steel Hex Nut.SLDPRT, 91290A079_Alloy Steel Socket Head Screw.SLDPRT, 91290A111_Alloy Steel Socket Head Screw (1).SLDPRT, 91290A120_Alloy Steel Socket Head Screw.SLDPRT, 91290A123_Alloy Steel Socket Head Screw.SLDPRT, 91290A125_Black-Oxide Alloy Steel Socket Head Screw M3 x 25.SLDPRT]
2023-05-04 Setting up altium project
    [CAN.SchDoc, Gripper PCB.PcbDoc, Gripper PCB.PrjPcb, Microcontroller.SchDoc, Motor Driver.SchDoc, Power.SchDoc, Sensor Feedback.SchDoc, Top Level.SchDoc]
2023-05-04 Added ICs to use
    [Top Level.SchDoc]
2023-05-05 Finished first draft of CAN and power supplies
    [CAN.SchDoc, Power.SchDoc, Top Level.SchDoc]
2023-05-05 Finished current sensing and H bridge
    [CAN.SchDoc, Gripper PCB.PcbDoc, Microcontroller.SchDoc, Motor Driver.SchDoc, Power.SchDoc, Sensor Feedback.SchDoc, Top Level.SchDoc]
2023-05-11 added connectors and board cutout
    [ASSY, GRIPPER, ROBOTIC ARM, 2023.DXF, Top Level.SchDoc]
2023-05-12 Added initial PCB shape
2023-05-17 Added budget and force sensor validation documents
    [Force Sensor Validation.xlsx, Reciepts.xlsx]
2023-05-17 working on CAD - updating the cover for the PCB
    [GRIPPER BODY,V2.SLDPRT, LINEAR ACTUATOR, ASSY,V2.SLDASM]
2023-05-17 added test points and FSR inputs
    [Sensor Feedback.SchDoc, Top Level.SchDoc]
2023-05-17 added op amp to buffer force measurement
    [Sensor Feedback.SchDoc]
2023-05-17 Did the force sensor testing
    [Force Sensor Validation.xlsx]
2023-05-18 Finished sensor feedback for FSRs
    [Force Sensor Validation.xlsx, Sensor Feedback.SchDoc]
2023-05-19 worked on cad and tried to fit in pcb
    [GRIPPER BODY,V2.SLDPRT, LINEAR ACTUATOR, ASSY,V2.SLDASM]
2023-05-19 edited dimensions for trapizoid
    [GRIPPER BODY,V2.SLDPRT]
2023-05-19 Completed all schematics initially
    gonna wait on review
    [ASSY, GRIPPER, ROBOTIC ARM, 2023.DXF, CAN.SchDoc, Force Sensor Validation.xlsx, Getting PCB Dimensions.SLDASM, Gripper PCB.PrjPcb, Microcontroller.SchDoc, Motor Driver.SchDoc, Part2^Getting PCB Dimensions.DXF]
2023-05-19 Forgot to connect debugging LEDs
    [Microcontroller.SchDoc]
2023-05-26 V2 waiting for more review
    [CAN.SchDoc, Microcontroller.SchDoc, Motor Driver.SchDoc, Power.SchDoc, Sensor Feedback.SchDoc, Top Level.SchDoc]
2023-05-29 One last review hopefully
    [Gripper PCB.PrjPcb, Power.SchDoc]
2023-06-02 Laid out PCB and separated components into each circuit
    [CAN.SchDoc, Microcontroller.SchDoc, Motor Driver.SchDoc, Power.SchDoc, Sensor Feedback.SchDoc, Top Level.SchDoc]
2023-06-03 finished laying out power components
    [Microcontroller.SchDoc, Power.SchDoc, Sensor Feedback.SchDoc]
2023-06-06 Finished initial component placement of PCB.
    [Sensor Feedback.SchDoc]
2023-06-06 Update Gripper PCB.step
2023-06-08 started routing stuff
    [CAN.SchDoc, Top Level.SchDoc]
2023-06-10 Finished PCB
    [Gripper PCB.PrjPcb]
2023-06-11 Placed new pcb for location purposed
    [LINEAR ACTUATOR, ASSY,V2.SLDASM]
2023-06-14 completed review from frerik
    [Microcontroller.SchDoc]
2023-06-14 production files outputted
    [Bill of Materials-Gripper PCB(X1).xlsx, CAN.SchDoc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]
2023-06-16 updated file struct
    [Bill of Materials-Gripper PCB(X1).xlsx, Gripper PCB.PrjPcb, Receipts.xlsx, Reciepts.xlsx]
2023-06-16 updated receipts
    [Receipts.xlsx]
2023-06-16 Working on CAD to accommodate the PCB. Creating separate PCB enclosure to be mounted onto the Gripper.
    [GRIPPER BODY,V2.SLDPRT, PCB Case.SLDPRT]
2023-06-26 Added 3d printed part to help with stenciling pcb
    [3D Printed Solder Holder.SLDPRT, 3D Printed Solder Holder.STL]
2023-06-29 Added new code to test PCB
2023-07-23 Added boilerplate code for current/force sensing
    Made GREEN LED blink on an interrupt
2023-08-03 wrote code for testing force sensors and created excel for recording testing results
    [Force Sensor Testing.xlsx]
2023-08-08 Tested PCB for force sensor, updated excel test sheet and the Arduino script
    [Force Sensor Testing.xlsx]
2023-08-08 fixed force sensor pins in software
    [Gripper_Arm.ino]
2023-08-13 added some can and current stuff
2023-08-13 working on current sensing
    [Force Sensor Testing.xlsx]
2023-08-17 Added some ADC testing code
    [Force Sensor Testing.xlsx]
2023-08-17 Done current sensing just gotta clean up
    [Force Sensor Testing.xlsx]
2023-08-17 Cleaned up current sensing code
2023-08-21 Update Force Sensor Testing.xlsx
    [Force Sensor Testing.xlsx]
2023-08-21 Updated force sensor testing data
    [Force Sensor Testing.xlsx]
